tonazza/005032/README.md

View this project on [CADLAB.io](https://cadlab.io/project/25240). 

# 005032
