tonazza/005032/005032.kicad_pcb

## KiCad design 005032.kicad_pcb (2022-02-22)

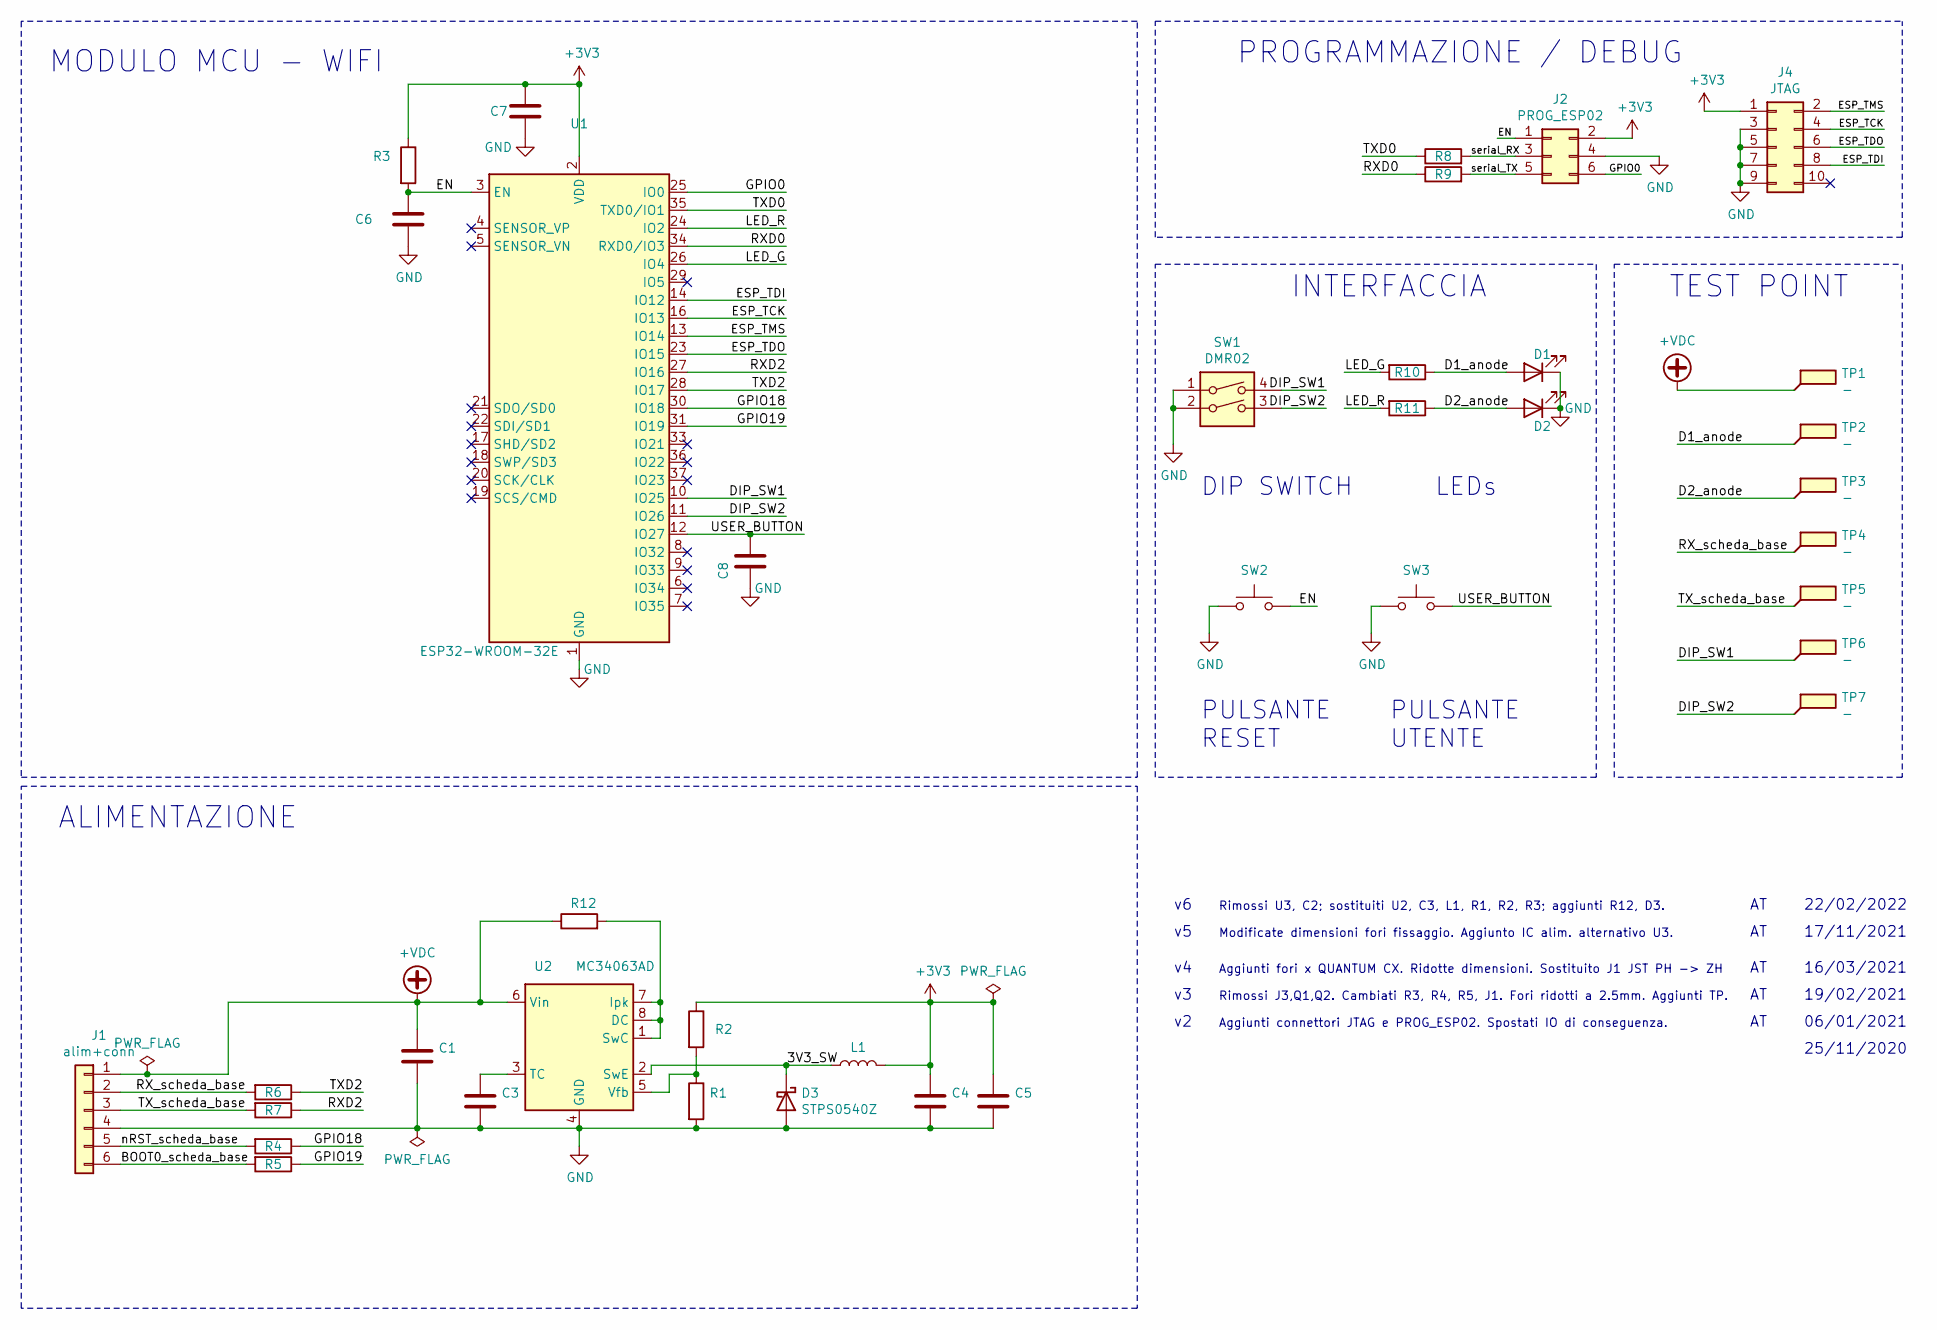
[picture p1: schematic 005032.sch, 005032 - modulo WiFi serie QUANTUM]

Parts:
C1: 10u/35; C_1206_3216Metric_Pad1.42x1.75mm_HandSolder
C3: 220p; C_0603_1608Metric
C4, C5: 22u/6.3; C_0805_2012Metric_Pad1.15x1.40mm_HandSolder
C6, C7, C8: 0.1u; C_0603_1608Metric
D1: 0603 green for 3.3V; LED_0603_1608Metric
D2: 0603 red for 3.3V; LED_0603_1608Metric
D3: STPS0540Z; D_SOD-123
J1: alim+conn; JST_ZH_S6B-ZR-SM4A-TF
J2: PROG_ESP02; IDC_2x03_P2.54mm_Vertical_SMD
J4: JTAG; IDC_2x05_P1.27mm_Vertical_SMD
L1: NRS5030T220MMGJ; L_Taiyo-Yuden_NR-50xx
R1: 11K 1%; R_0603_1608Metric
R2, R3: 18K 1%; R_0603_1608Metric
R4, R5, R6, R7, R8, R9, R10, R11: 100R; R_0603_1608Metric
R12: 0R33 1%; R_1206_3216Metric_Pad1.42x1.75mm_HandSolder
SW1: DMR02; SW_DIP_SPSTx02_Slide_6.7x6.64mm_W8.61mm_P2.54mm_LowProfile
SW2, SW3: 434153017835; SW_Push_1P1T_NO_3.5x2.8
TP1, TP2, TP3, TP4, TP5, TP6, TP7: -; TestPoint_round_2.0mm
U1: ESP32-WROOM-32E
U2: MC34063AD; SOIC-8_3.9x4.9mm_P1.27mm

Connections:
+3V3: C4.1, C5.1, C7.1, J2.2, J4.1, L1.2, R2.1, R3.1, U1.2 (VDD)
+VDC: C1.1, J1.1, R12.1, TP1.1, U2.6 (Vin)
/3V3_SW: D3.1 (K), L1.1, U2.2 (SwE)
/BOOT0_scheda_base: J1.6, R5.2
/D1_anode: D1.2 (A), R10.1, TP2.1
/D2_anode: D2.2 (A), R11.1, TP3.1
/DIP_SW1: SW1.4, TP6.1, U1.10 (IO25)
/DIP_SW2: SW1.3, TP7.1, U1.11 (IO26)
/EN: C6.1, J2.1, R3.2, SW2.2, U1.3 (EN)
/ESP_TCK: J4.4, U1.16 (IO13)
/ESP_TDI: J4.8, U1.14 (IO12)
/ESP_TDO: J4.6, U1.23 (IO15)
/ESP_TMS: J4.2, U1.13 (IO14)
/GPIO0: J2.6, U1.25 (IO0)
/GPIO18: R4.1, U1.30 (IO18)
/GPIO19: R5.1, U1.31 (IO19)
/LED_G: R10.2, U1.26 (IO4)
/LED_R: R11.2, U1.24 (IO2)
/RXD0: R9.1, U1.34 (RXD0/IO3)
/RXD2: R7.1, U1.27 (IO16)
/RX_scheda_base: J1.2, R6.2, TP4.1
/TXD0: R8.1, U1.35 (TXD0/IO1)
/TXD2: R6.1, U1.28 (IO17)
/TX_scheda_base: J1.3, R7.2, TP5.1
/USER_BUTTON: C8.2, SW3.2, U1.12 (IO27)
/nRST_scheda_base: J1.5, R4.2
/serial_RX: J2.3, R8.2
/serial_TX: J2.5, R9.2
GND: C1.2, C3.2, C4.2, C5.2, C6.2, C7.2, C8.1, D1.1 (K), D2.1 (K), D3.2 (A), J1.4, J2.4, J4.3, J4.5, J4.7, J4.9, R1.2, SW1.1, SW1.2, SW2.1, SW3.1, U1.1 (GND), U1.15 (GND), U1.38 (GND), U1.39 (GND), U2.4 (GND)
unnamed: C3.1, U2.3 (TC)
unnamed: R1.1, R2.2, U2.5 (Vfb)
unnamed: R12.2, U2.1 (SwC), U2.7 (Ipk), U2.8 (DC)

Notes on the sheet:
25/11/2020
PROGRAMMAZIONE / DEBUG
MODULO MCU - WIFI
ALIMENTAZIONE
INTERFACCIA
PULSANTE RESET
PULSANTE UTENTE
DIP SWITCH
LEDs
Aggiunti connettori JTAG e PROG_ESP02. Spostati IO di conseguenza.
06/01/2021
19/02/2021
Rimossi J3,Q1,Q2. Cambiati R3, R4, R5, J1. Fori ridotti a 2.5mm. Aggiunti TP.
TEST POINT
Aggiunti fori x QUANTUM CX. Ridotte dimensioni. Sostituito J1 JST PH -> ZH
16/03/2021
Modificate dimensioni fori fissaggio. Aggiunto IC alim. alternativo U3.
17/11/2021
Rimossi U3, C2; sostituiti U2, C3, L1, R1, R2, R3; aggiunti R12, D3.
22/02/2022

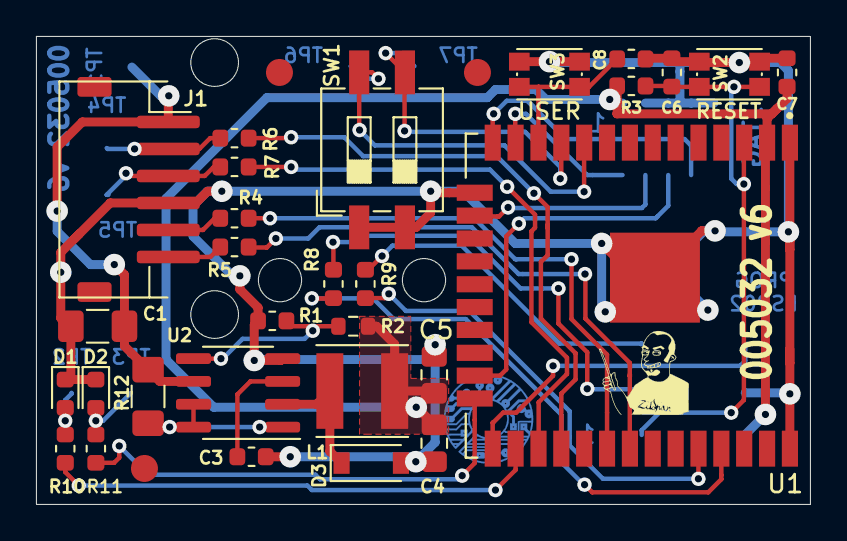
[picture p2: board 005032.kicad_pcb from above]

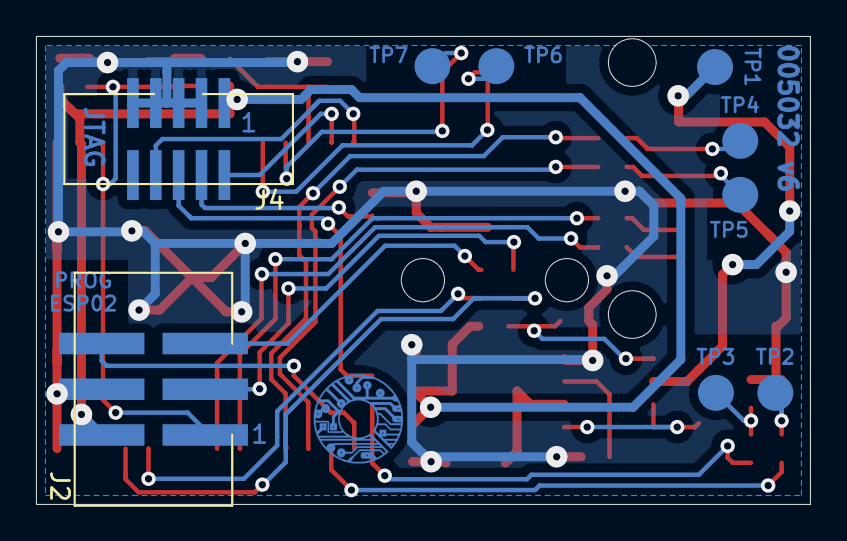
[picture p3: board 005032.kicad_pcb from below]

Board: 2 copper layers, 43.0 x 26.0 mm, 42 parts (9 on the bottom side), 32 nets.

Other parts of the board:
Hole2.4_1, Hole2.4_2: Hole_2.4mm
Hole2.65_1, Hole2.65_2: Hole_2.65mm
