tonazza/005032/(commit log)

2022-02-21 v5 - primo commit
    [005032-B_Cu.gbr, 005032-B_Mask.gbr, 005032-Edge_Cuts.gbr, 005032-F_Cu.gbr, 005032-F_Mask.gbr, 005032-F_Paste.gbr, 005032-F_SilkS.gbr, 005032-NPTH.drl]
2022-02-22 v5 - commit prima di esecuzione modifiche v6
    [005032.kicad_pcb, 005032.sch]
2022-02-22 v6 - modificato schema (PCB ancora in v5)
    [005032.sch, 005032_bom_v1.tsv, 005032_bom_v2.tsv, 005032_bom_v3.tsv, 005032_bom_v4.tsv]
2022-02-22 v6 - modificato PCB (TEMP - in attesa revisione meccanica per montaggio su QUANTUM EX 100/150)
    [005032.kicad_pcb, 005032.sch, 005032_bom_v1.tsv, 005032_bom_v2.tsv, 005032_bom_v3.tsv, 005032_bom_v4.tsv]
